thermseekr/eumesmo-rl-8ch8a/V1/eumesmo-rl-8ch8a-v1.2.png

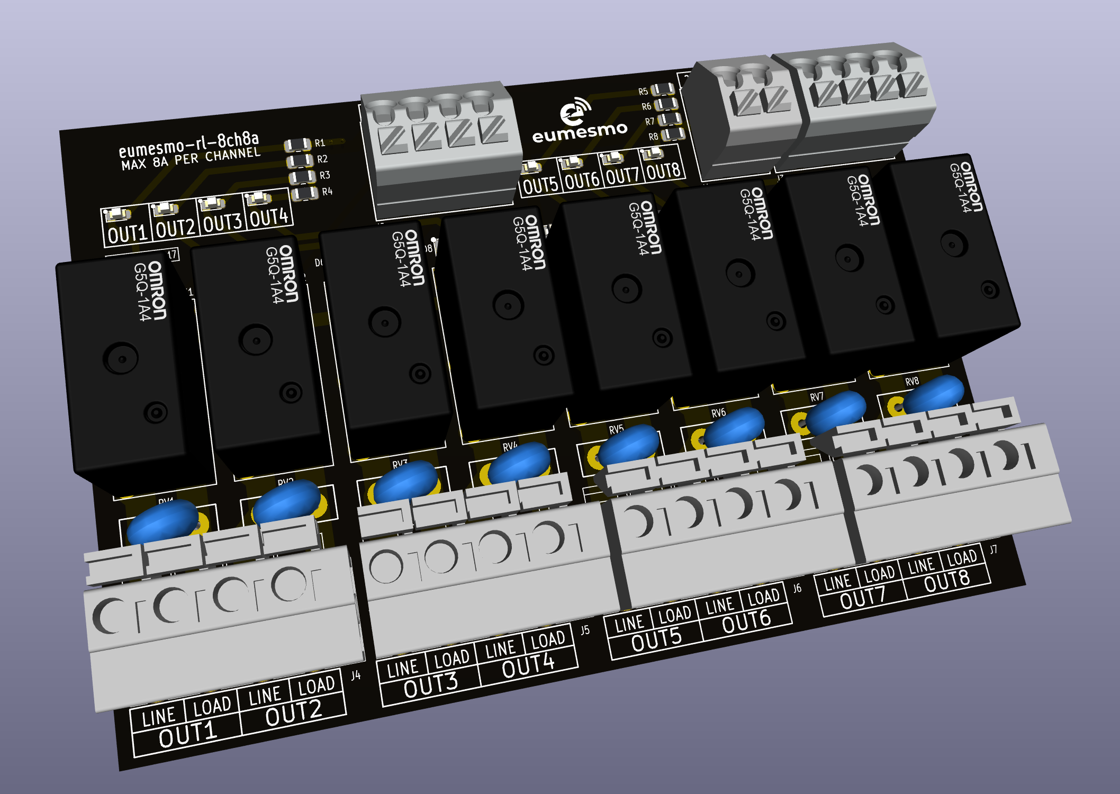
V1/eumesmo-rl-8ch8a-v1.2.png
