thermseekr/eumesmo-rl-8ch8a/V1/production/bom.csv

Designator | Footprint | Quantity | Value | LCSC Part #
D1, D11, D13, D15, D3, D5, D7, D9 | 0603 | 8 | ORANGE/0603 | C2987557
D10, D12, D14, D16, D2, D4, D6, D8 | D_SOD-123 | 8 | 1N4148 | C81598
J1 | TerminalBlock_Wago_250-202_1x02_P3.5mm_45Degree | 1 | 250-202 | C475154
J2, J3 | TerminalBlock_Wago_250-204_1x04_P3.5mm_45Degree | 2 | 250-204 | C475156
J4, J5, J6, J7 | TerminalBlock_Dibo_DB142V-5.08-4P_1x04_P5.08mm_Vertical | 4 | DB142V-5.08-4P | C2898701
K1, K2, K3, K4, K5, K6, K7, K8 | Relay_SPST_Omron-G5Q-1A | 8 | G5Q-1A4-DC24V | C89311
R1, R2, R3, R4, R5, R6, R7, R8 | 0805 | 8 | 10k/125mW | C17414
RV1, RV2, RV3, RV4, RV5, RV6, RV7, RV8 | RV_Disc_D9.50mm_W3.6mm_P5.08mm | 8 | 275VAC | C2761646
