thermseekr/eumesmo-rl-8ch8a/V1/Output/eumesmo-rl-8ch8a-v1-Edge_Cuts.dxf

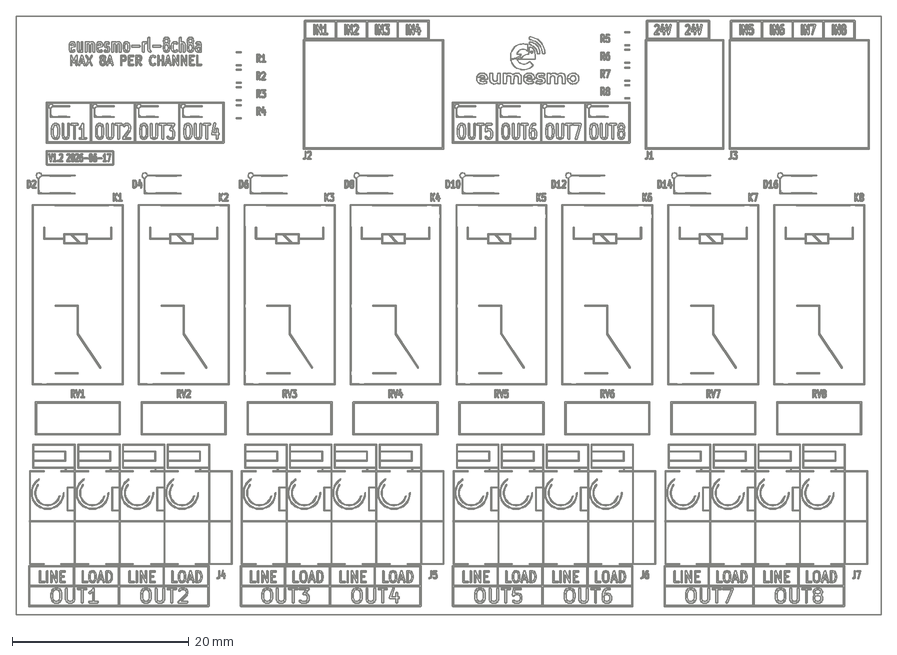
[picture p2: CAD file, 2026-07-21]
V1/Output/eumesmo-rl-8ch8a-v1-Edge_Cuts.dxf
98.0 x 67.8 mm
