thermseekr/eumesmo-rl-8ch8a/V1/eumesmo-rl-8ch8a-v1.kicad_pcb

## KiCad design V1/eumesmo-rl-8ch8a-v1.kicad_pcb (2026-10-19)

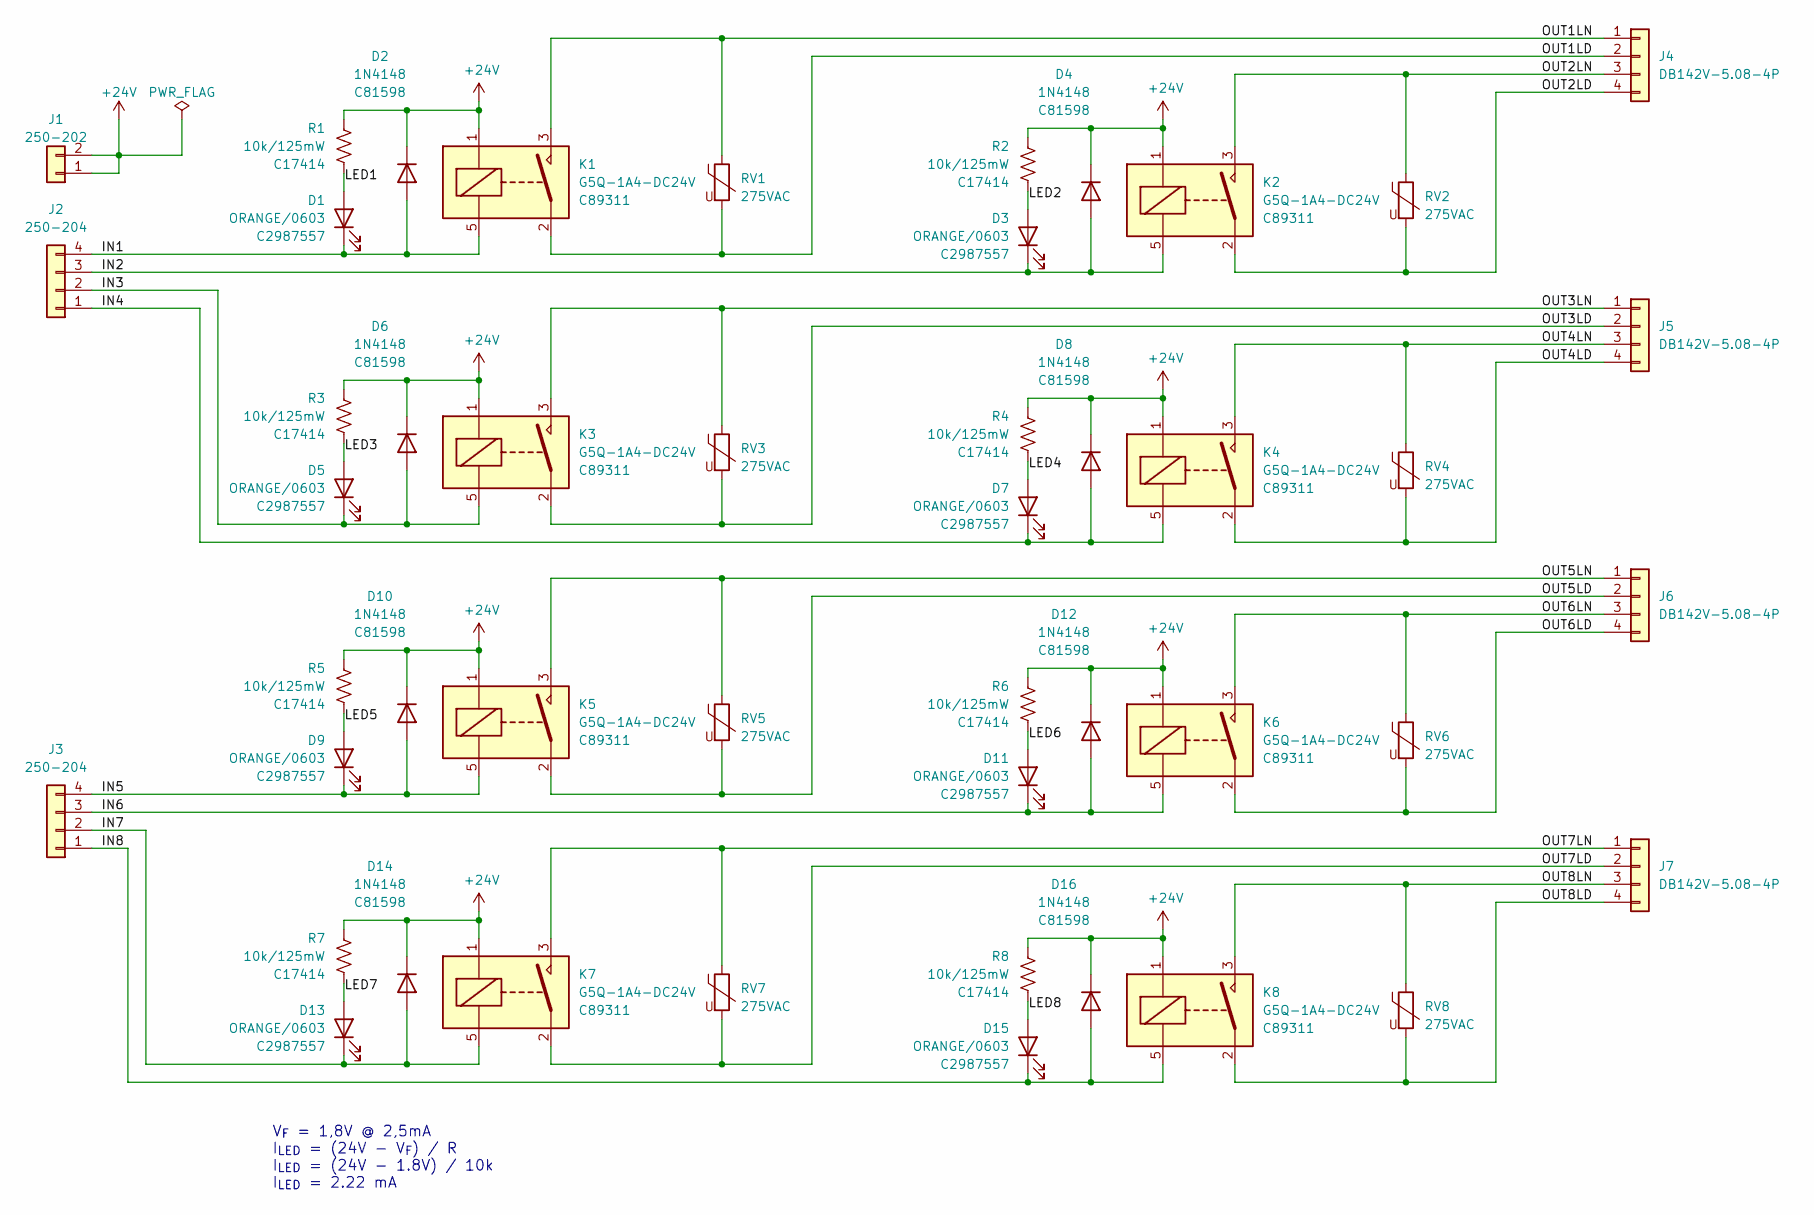
[picture p3: schematic eumesmo-rl-8ch8a-v1.kicad_sch, eumesmo 8x 24V 8A NO Relay Module]

Parts:
D1, D3, D5, D7, D9, D11, D13, D15: ORANGE/0603; LED_0603_1608Metric; Mfr PN 19-217/S2C-AL1M2VY/6T; LCSC Part # C2987557
D2, D4, D6, D8, D10, D12, D14, D16: 1N4148; D_SOD-123; Mfr PN 1N4148W; LCSC Part # C81598
J1: 250-202; TerminalBlock_Wago_250-202_1x02_P3.5mm_45Degree; Mfr PN KF250-3.5-2P-1; LCSC Part # C475154
J2, J3: 250-204; TerminalBlock_Wago_250-204_1x04_P3.5mm_45Degree; Mfr PN KF250-3.5-4P-1; LCSC Part # C475156
J4, J5, J6, J7: DB142V-5.08-4P; TerminalBlock_Dibo_DB142V-5.08-4P_1x04_P5.08mm_Vertical; Mfr PN DB142V-5.08-4P-GN; LCSC Part # C2898701
K1, K2, K3, K4, K5, K6, K7, K8: G5Q-1A4-DC24V; Relay_SPST_Omron-G5Q-1A; Mfr PN G5Q-1A4-DC24V; LCSC Part # C89311
R1, R2, R3, R4, R5, R6, R7, R8: 10k/125mW; R_0805_2012Metric; Mfr PN 0805W8F1002T5E; LCSC Part # C17414
RV1, RV2, RV3, RV4, RV5, RV6, RV7, RV8: 275VAC; RV_Disc_D9.50mm_W3.6mm_P5.08mm; Mfr PN RM07D431KC1IE100; LCSC Part # C2761646

Connections:
+24V: D2.1 (K), D4.1 (K), D6.1 (K), D8.1 (K), D10.1 (K), D12.1 (K), D14.1 (K), D16.1 (K), J1.1, J1.2, K1.1, K2.1, K3.1, K4.1, K5.1, K6.1, K7.1, K8.1, R1.1, R2.1, R3.1, R4.1, R5.1, R6.1, R7.1, R8.1
/IN1: D1.1 (K), D2.2 (A), J2.4, K1.5
/IN2: D3.1 (K), D4.2 (A), J2.3, K2.5
/IN3: D5.1 (K), D6.2 (A), J2.2, K3.5
/IN4: D7.1 (K), D8.2 (A), J2.1, K4.5
/IN5: D9.1 (K), D10.2 (A), J3.4, K5.5
/IN6: D11.1 (K), D12.2 (A), J3.3, K6.5
/IN7: D13.1 (K), D14.2 (A), J3.2, K7.5
/IN8: D15.1 (K), D16.2 (A), J3.1, K8.5
/LED1: D1.2 (A), R1.2
/LED2: D3.2 (A), R2.2
/LED3: D5.2 (A), R3.2
/LED4: D7.2 (A), R4.2
/LED5: D9.2 (A), R5.2
/LED6: D11.2 (A), R6.2
/LED7: D13.2 (A), R7.2
/LED8: D15.2 (A), R8.2
/OUT1LD: J4.2, K1.2, RV1.2
/OUT1LN: J4.1, K1.3, RV1.1
/OUT2LD: J4.4, K2.2, RV2.2
/OUT2LN: J4.3, K2.3, RV2.1
/OUT3LD: J5.2, K3.2, RV3.2
/OUT3LN: J5.1, K3.3, RV3.1
/OUT4LD: J5.4, K4.2, RV4.2
/OUT4LN: J5.3, K4.3, RV4.1
/OUT5LD: J6.2, K5.2, RV5.2
/OUT5LN: J6.1, K5.3, RV5.1
/OUT6LD: J6.4, K6.2, RV6.2
/OUT6LN: J6.3, K6.3, RV6.1
/OUT7LD: J7.2, K7.2, RV7.2
/OUT7LN: J7.1, K7.3, RV7.1
/OUT8LD: J7.4, K8.2, RV8.2
/OUT8LN: J7.3, K8.3, RV8.1

Notes on the sheet:
V_{F} = 1,8V @ 2,5mA I_{LED} = (24V - V_{F}) / R I_{LED} = (24V - 1.8V) / 10k I_{LED} = 2.22 mA

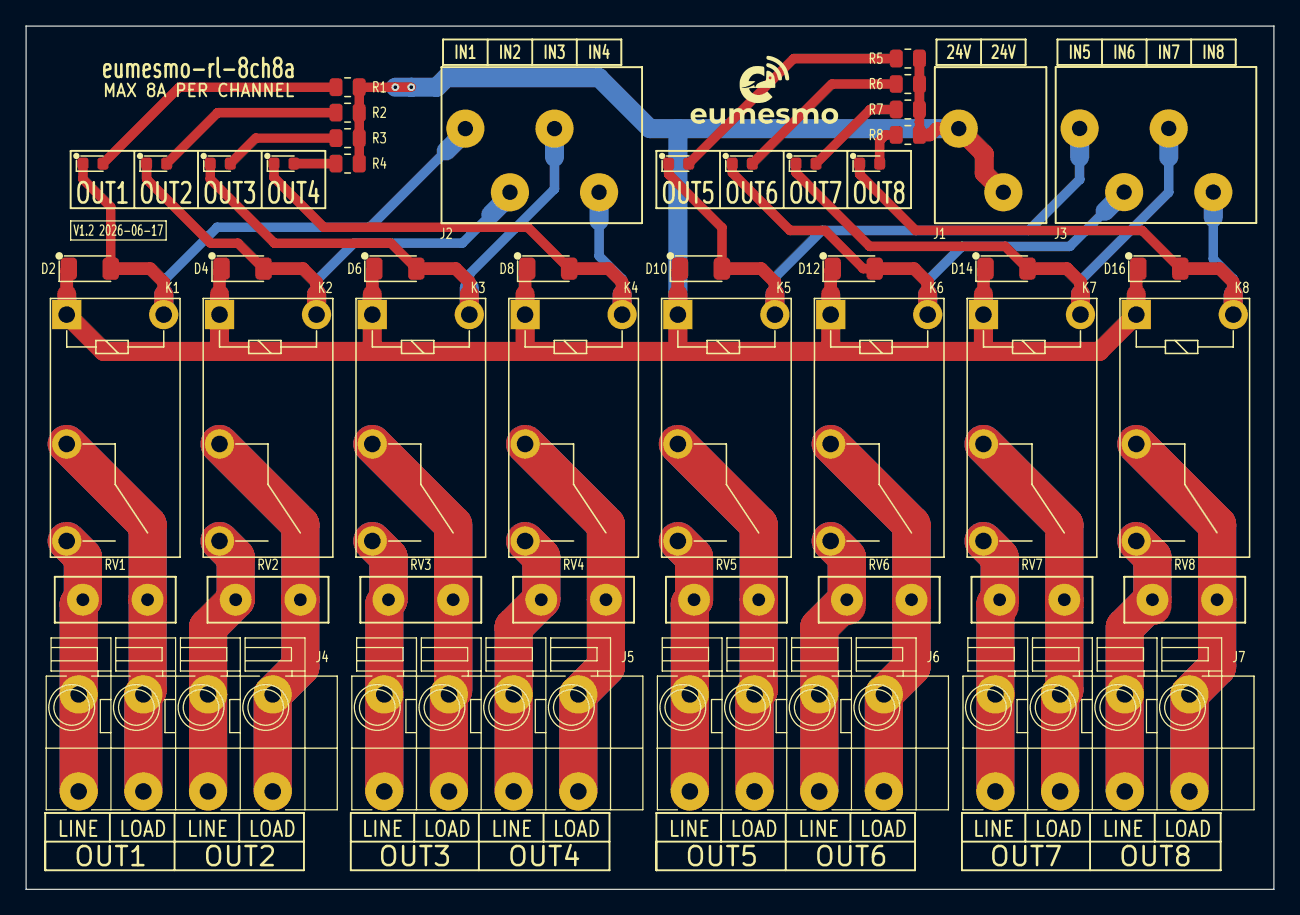
[picture p4: board eumesmo-rl-8ch8a-v1.kicad_pcb from above]

Board: 2 copper layers, 98.0 x 67.8 mm, 47 parts (0 on the bottom side), 33 nets.
