thermseekr/eumesmo-rl-8ch8a/(commit log)

2026-06-17 Release V1.2.0
    [eumesmo-rl-8ch8a-v1.kicad_pcb, eumesmo-rl-8ch8a-v1.kicad_sch]
2026-07-06 Replaced 0603 size 10k resistor for 0805 size.
    [bom.csv, eumesmo-rl-8ch8a-v1.kicad_pcb, eumesmo-rl-8ch8a-v1.kicad_sch, positions.csv]
2026-07-08 Replaced 0603 size 10k resistors for 0805 size.
2026-07-21 Plotted DXF for EPLAN
    [eumesmo-rl-8ch8a-v1-Edge_Cuts.dxf, eumesmo-rl-8ch8a-v1.kicad_pcb]
2026-08-28 Revised Metaltex holders
    [eumesmo-rl-8ch8a-v1.kicad_pcb]
2026-09-10 Updated information regarding max current per channel.
    [eumesmo-rl-8ch8a-v1.kicad_pcb]
2026-09-11 LEDs changed to orange
    [bom.csv, eumesmo-rl-8ch8a-v1.kicad_pcb, eumesmo-rl-8ch8a-v1.kicad_sch]
2026-09-11 LEDs replaced for orange
    [bom.csv, eumesmo-rl-8ch8a-v1.kicad_pcb, eumesmo-rl-8ch8a-v1.kicad_sch]
2026-09-21 Adjusted component rotation and offset information for JLCPCB.
    [eumesmo-rl-8ch8a-v1.kicad_pcb, eumesmo-rl-8ch8a-v1.kicad_sch, positions.csv]
2026-09-21 Adjusted comment regarding DIN rail modules.
    [eumesmo-rl-8ch8a-v1.kicad_pcb]
2026-09-23 Adjusted terminal block positions
    [eumesmo-rl-8ch8a-v1.kicad_pcb, positions.csv]
2026-10-19 Replaced Wago connectors for other brand, no stock.
